branstem/OperationAwesome/media/IMG_0681.JPG

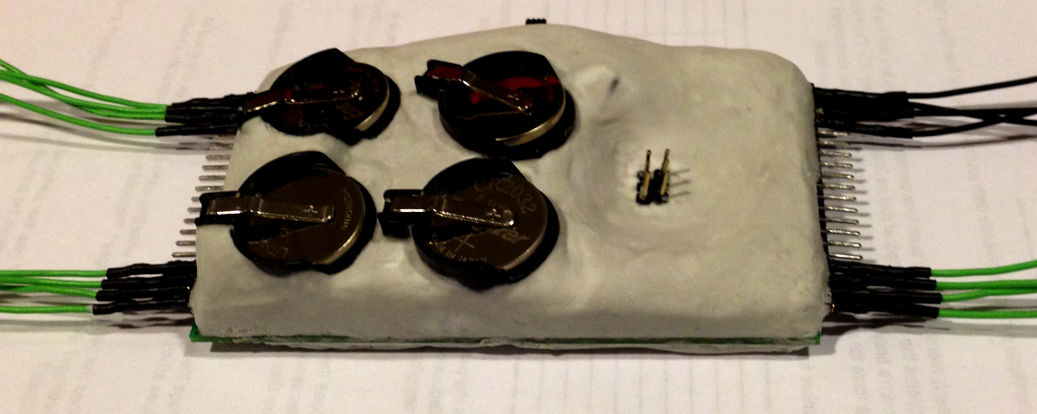
media/IMG_0681.JPG
