branstem/OperationAwesome/media/IMG_0678.JPG

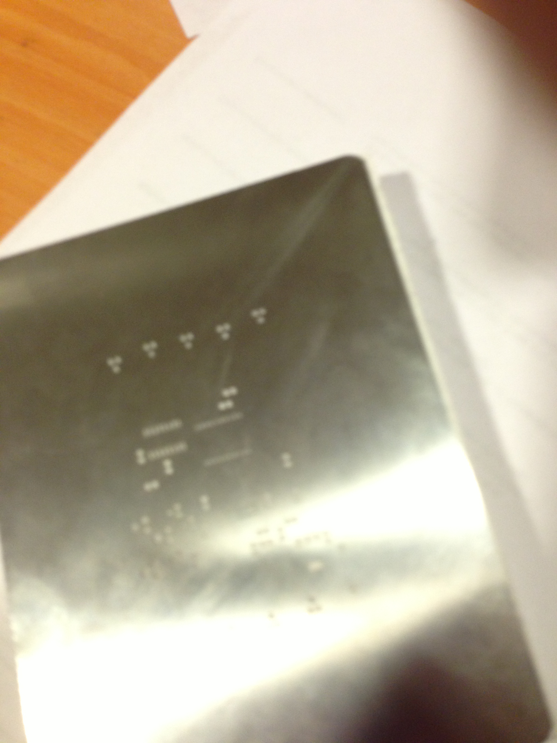
media/IMG_0678.JPG
