branstem/OperationAwesome/README.md

OperationAwesome
================

ECE411 Project
