branstem/OperationAwesome/schematics/readme.txt

This folder was made for circuits.

All unique symbols not shipped with eaglecad should be added to symbols.lbr. 

This library file should also be added to eagles library path to load and 
edit the file.
