branstem/OperationAwesome/datasheets/readme.txt

File in this directory are datasheet for devices used in the schematic.
Please format them as 

Partnumber - function | device class.xxx
