branstem/OperationAwesome/assignments/Assignment 2 - Project Proposal.odt

Proposal for the Design of a Frisbee That Lights Up Based On Measured Acceleration

Matthew Branstetter

Vernon Jones

Yusuf Qedan

Tyler Tricker

ECE411 Practicum Project – Operation Awesome

Electrical Computer Engineering, Portland State University

Submitted to:

Mark Faust

Electrical Computer Engineering, Portland State University

Contents

Executive Summary 3

Design Proposal 3

Project Management 4

Deliverables 4

Budget 4

Wiki 4

Appendix A: Design Matrix 5

Appendix B: Potential Projects 7

Executive Summary

For our ECE 411 practicum project fall term 2012 we need to design something that meets some specific criteria but otherwise is open creatively. Our team discussed several different projects and narrowed the field to four (see appendix B). We then completed a decision matrix to help in decide the project to propose (see appendix A).

The project we chose was not very complex, wouldn’t require significant time to construct and test, and the cost to build is rather conservative. Our focus could be better devoted to the actual design process itself rather than the design. In addition we are able to distinctly assign roles amongst the team based on strengths of team members for the design we chose. Some members are better suited for programming as opposed to hardware. Others have more experience in creating website and wiki’s. Cross loading the workload and utilizing team member strengths will lend to actually have a working design at the completion of the project.

Outside of the criteria, we would like to develop a better understanding of the process or steps in which a product goes through before it reaches the shelf or can be purchased by the consumer. This will help facilitate successful completion of our Capstone Project, and provide answers to possible interview questions following graduation. This project will also build on our knowledge of Electrical and Computer Engineering and aid in getting hired despite our lack of industry experience.

Design Proposal

Our team would like to propose to build a Frisbee which when thrown will light up strategically placed LED’s. The greater the acceleration of the Frisbee the more LED’s that will light up. The uniqueness of the Frisbee will lend to competition amongst throwers to have the most LED’s light up, and for tossing the Frisbee during low light visibility conditions.

The design will consist of a gyro sensor which will provide input to the microcontroller and RGB LED’s that will light up and be the output. An Atmel AVR microcontroller will be used in the design. The PCB will be two sided. The PCB will be no larger than 30 cm². The PCB will be majority surface mount materials. We will utilize a CR123 lithium battery to power the design. The design will be self-contained and be attached to a Frisbee purchased from a local vendor. The Frisbee will be minimally altered to accommodate the PCB and attached LED’s without significantly affecting normal flight response.

On completion of the project our team will have:

1. A completed and working design.
2. Learned the process of designing a product.
3. Gained more hands on experience in our field of study.

Project Management

Our team will utilize a Wiki to update our progress and to augment our regular lines of communication. In addition each member will maintain a design notebook and a log of their time spent on the project. We will meet twice a week to discuss our progress and make any necessary changes or adjustments to successfully complete the project by December 5, 2012.

Deliverables

At the end of the project we will have four working Frisbees in which to demonstrate to our professor. We will also provide video of significant achievements throughout the design progress.

Budget

Out budget is no more than $150 dollars per Frisbee for the project.

Wiki

https://projects.cecs.pdx.edu/projects/fa2012ece411-operationawesome

Appendix A:

Decision Matrix

Project | Complexity 30% | Time 20% | Reliability 15% | Scalability 13% | Re-usability 12% | Inverse Cost 10% | Total 100%
Light up Frisbee | 9 | 9 | 10 | 4 | 4 | 10 | 8
Color calendar | 6 | 7 | 8 | 10 | 7 | 3 | 6.84
Pitch meter | 6 | 7 | 9 | 4 | 6 | 10 | 6.79
Zone Lighting Controller | 6 | 4 | 8 | 10 | 10 | 6 | 6.9

*Criteria is graded on a 0-10 scale where 0 means does not apply or negligible. Higher Numbers are better.

Criteria Selection

The group sat down to decide criteria that was important to us and then ranked them based on our personal preferences. The number selection was generated by each member grading all of the projects, these were then aggregated and rounded to the nearest whole number.

Complexity

Complexity is a measure of the estimated difficulty of design. A Project with a high complexity covers several disjunct disciplines and involves technology unfamiliar to the team members.

Time

Time represents an estimate for time required in design, development, manufacturing, and testing. Some projects might be simple to design but take significant time testing and polishing code.

Reliability

How likely is the project going to work or function during demos and how easily the project would be to operate from other group members.

Scalability

Scalability is a measure of how well the project can be scaled up or down to meet a deadline. Projects with a high scalability means that the project can be extended or reduced without any redesign.

Re-usability

How well the project could be reintegrated into a future project or re-purposed into a different project.

Inverse Cost

Projected Cost Analysis. To keep everything as larger is better the inverse cost score is given. Where 10 is considered to be negligible and 0 would be over $100 per person.

Scale Factors

The simplest scaling formula would be 100% = x1 + x2..... where n of xn is the project number. This scaling factor ignores our personal preferences though so criteria more important to us will be scaled more than that of other criteria. To prevent unfair bias a generic decay formula was derived using a minimum weight and the categories prioritized.

Appendix B:

Potential Projects

Light up Frisbee

A Frisbee that will sense when thrown using a gyroscopic sensor. The average steady state velocity of a Frisbee when thrown is roughly 6 meters per second. Using a motion sensor (G force detector) such as the Durakool G force detector (part number 20878 - T018 Series), when the Frisbee exceeds 6 meters per second it would light up strategically placed LED’s on the Frisbee. The higher the velocity the more LED’s that would light up.

Color Calendar

An automatic time keeper that displays the time and date using color visuals. The input to the device would be a combination of dip switches for daylight savings and time zone information. The time and date itself would be RF synchronized with either the WWCB atomic clock or GPS timestamps. The display itself would be based on natural references, moon cycles, seasons, and atmosphere color changes.

Pitch Meter

A meter with an LED display that changes with a change of pitch. Input would be a microphone or line in. The display would be a series of RGB LEDs that change with color depending on the FFT of the input.

Zone Lighting Controller

A controller with motion detectors that can keep track of a person’s movements and turns lights on and off depending on where they are and where they are heading. The idea was to use sonar sensors to determine a passing persons velocity and position. By using multiple sensors a path and can keep track of multiple people, allowing to automated lighting. Inputs would be the sonar sensors, outputs would be lighting signals to turn zone lights on and off.
