branstem/OperationAwesome/assignments/Assignment 3 - Project Design Specification.odt

Project Design Specification: Frisbee That Lights Up Based On Measured Angular Acceleration and Velocity

Matthew Branstetter

Vernon Jones

Yusuf Qedan

Tyler Tricker

ECE411 Practicum Project – Operation Awesome

Electrical Computer Engineering, Portland State University

Contents

Version notice

All revisions of this document are listed in chronological order. There is no relationship between the document number and the software release number.

Document release | Date | Description
Draft 1 | 08/13/2012 | Established Client Requirements
Draft 2 | 08/14/2012 | Established Design Requirements
Release 1 | 08/15/2012 | First release.
Release 2 | 12/04/2012 | Removed specifications for submerging in 10 M of water, cleaned up format, deleted extraneous specifications outlined in both performance, environmental, product characteristics, and miscellaneous.

This document was created by Operation Awesome, Portland State University. Operation Awesome has made every effort to ensure that this document is accurate at the time of printing. Obtain additional copies of this document, as well as updated releases, from the following organization:

Matthew Branstetter

c/o Operation Awesome

1020 Madison St.

Silverton, OR 97381

Phone: 503-873-3181

Email: matthew.branstetter@hotmail.com

Trademarks

The trademarks contained in this document are the property of their respective owners.

1. Introduction

Purpose

The Project Design Specification (PDS) identifies client and design requirements in order to produce a functioning device. It also provides a benchmark to which designs will be validated.

Scope

For our ECE 411 practicum project fall term 2012 we need to design something that meets some specific criteria but otherwise is open creatively. Outside of the criteria, we would like to develop a better understanding of the process or steps in which a product goes through before it reaches the shelf or can be purchased by the consumer. This will help facilitate successful completion of our Capstone Project, and provide answers to possible interview questions following graduation. This project will also build on our knowledge of Electrical and Computer Engineering and aid in getting hired despite our lack of industry experience.

Summary of changes

The initial draft was created after identifying the client requirements. Additionally, the second draft was created after analyzing the client requirements and our group identifying design requirements. The changes can be seen in Client and Design requirements within this document.

Review/Concurrence information

Matthew Branstetter Initial Review of Draft 1, Draft 2, and Release 1

Vernon Jones Initial Review of Draft 1, Draft 2, and Release 1

Yusuf Qedan Initial Review of Draft 1, Draft 2, and Release 1

Tyler Tricker Initial Review of Draft 1, Draft 2, and Release 1

Mark Faust Review of Release 1

2. Client requirements

Your project can do almost anything but must satisfy the following course requirements:

- Have one or more inputs or sensors.
- Have one or more outputs or transducers.
- Have one or more processing modules which control some of the outputs based on the inputs.
- Use a two layer PCB that is between 1 and 16 in2, with no side of the board being less than 1 inch or more than 12 inches.
- Use components that can be hand soldered or easily soldered in a crude reflow oven.

3. Design requirements

a. Physical and Operational characteristics:

  Performance Requirements

The disk must still be able to sustain flight after assembly. Rotational inertia should be minimally effected. The device must operate in damp conditions. The device must be able to withstand sustained shocks. Batteries must be replaceable.

  Safety

The device must be void of sharp edges that could cut or slice soft tissue at the touch. All electronics must be fully sheathed and covered to protect against burns.

  Testing

The system must be tested for functionality and reliability. Reliability testing must test the requirements outlined in the Operating Environment. The Functionality testing must test the client requirements. Testing may be destructive so multiple prototypes may be desirable.

  Accuracy and Reliability

The gyro sensor should recognize when Frisbee is thrown with a sensitivity of 2000 degrees per second.

  Life in Service

The device will be used multiple times and must last for a minimum of two years.

  Shelf Life

The device must be able to be used for up to two years after production.

  Operating Environment

The device will be used in an outdoor environment and must be able to withstand temperatures ranging between 0 and 55 degrees Celsius (32 and 130 degrees Fahrenheit). The device must be able to withstand surface water without damaging any electrical components.

  Ergonomics

The additional weight of the disc should not increase the rotational inertia high enough so as to cause the user discomfort. Any batteries should be easily replaceable.

  Size

The package must fit on a standard sized disk; standard being defined by the World Flying Disc Federation.

  Materials

The electrical system must consist of a 2 layer PCB, containing more than 75% of surface mount components. The design may be designed in Eagle-CAD. Due to the mobility constraints of a flying disc, it should be operational off a standard battery pack. The PCB must have silk screening as required by the client.

  Cleaning

Device must be able to be cleaned with a moist cloth and should be able to be placed under a typical kitchen faucet with running water without damaging any electrical components.

b. Product Characteristics

  Quantity

One prototype should be constructed. More maybe made as required. The prototype may not be required to follow the same tests as the finished product but the finished product must be tested.

c. Miscellaneous:

  Target Product Cost

Device will be sold singularly to Frisbee enthusiasts. The cost should be no greater than $100.

  Usability
  The disc should be easily usable by any novice flying disc thrower.
  Legal

All design and manufacturing must not infringe on another parties: copyright, trademark, patent rights, or intellectual property. This Project is also released under the GPLv2 license.

  References

GNU GPLv2 - http://www.gnu.org/licenses/gpl-2.0.html.
World Flying Disc Association - http://www.wfdf.org/

Rev. 12/7/2012 Design Project Specification.doc
