branstem/OperationAwesome/assignments/Assignment 4 - Schematic Coversheet.odt

Project Design Specification: Frisbee That Lights Up Based On Measured Angular Acceleration and Velocity

Logical Schematics

Matthew Branstetter

Vernon Jones

Yusuf Qedan

Tyler Tricker

ECE411 Practicum Project – Operation Awesome

Electrical Computer Engineering, Portland State University

Rev. 10/24/2012 1 Design Project Specification.doc
