branstem/OperationAwesome/assignments/System Design and Modeling.pptx

## System Design and Modeling: Frisbee That Lights Up Based On Measured Angular Acceleration and Velocity

Matthew Branstetter
Vernon Jones
Yusuf Qedan
Tyler Tricker
ECE411 Practicum Project – Operation Awesome
Electrical Computer Engineering, Portland State University

## Light-up Frisbee Level 0 Block Diagram

Power 5-7V

Light-up Frisbee

10 RGB LEDs

Module | Light Up Frisbee
Inputs | Power 6V from 2 lithium batteries
Outputs | 10 RGB LED’s 40 pins common anode configuration
Functionality | Based on the measured angular velocity 10 RGB LEDs will light up different patterns and colors

## Light-up Frisbee Level 1 Block Diagram

Logic Power Supply

Power 5v-7V

3.3 V

Lighting Module

3.3 V

Row
Strobe
and
Reset

Logic Module

RGB
LED Outputs

Red Column
Blue Column
Green Column

## Logic Power Supply: Level 0 Block Diagram

Power 5-7V

Logic Power Supply

Power 3.3V

Module | Logic Power Supply
Inputs | Power 5-7V from 2 lithium batteries
Outputs | Power 3.3V
Functionality | Maintains a constant output voltage of 3.3V

## Logic Power Supply: Level 1 Block Diagram

Power 5-7V

Diode

Cap

Voltage Regulator

Power 3.3V

Cap

Decoupling

## Logic Module: Level 0 Block Diagram

Power 3.3V

Logic Circuit

Row Strobe
Row Reset

Red Column
Blue Column
Green Column

Module | Logic Circuit
Inputs | Power 3.3V
Outputs | Row Strobe – Signal to the lighting circuit to activate the next LED. | Red Column – PWM for red brightness
| Row Reset - Signal to the lighting circuit to return to LED0. | Blue Column – PWM for blue brightness
| | Green Column – PWM for blue brightness
Functionality | Measures a rotational velocity and outputs lighting signals as a function of the rotational velocities value.

## Logic Module: Level 1 Block Diagram

Power 3.3V

Gyroscope

ATTINY261

ZOUT

Row Strobe
Row Reset

Red Column
Blue Column
Green Column

## Lighting Module: Level 0 Block Diagram

5-7 V

3.3 V

Lighting Module

Row
Strobe
and
Reset

RGB
Strobe

RGB
LED Outputs

Module | Logic Circuit
Inputs | Row Strobe – Signal to the lighting circuit to activate the next LED. | Red Column – PWM for red brightness
| Row Reset - Signal to the lighting circuit to return to LED0. | Blue Column – PWM for blue brightness
| | Green Column – PWM for blue brightness
Output | 10 RGB LED Outputs
Functionality | Takes lighting signals from the Logic Module and pulses LEDs according to the signal

## Lighting Module: Level 1 Block Diagram

5-7V

3.3 V

Row
Strobe
and
Reset

4017 Decade Decoder

Transistor Array

Transistor Array

Current
Limiter

RGB LED
Anode
Outputs

RGB
Strobe

Red Column
Green Column
Blue Column
