branstem/OperationAwesome/assignments/Final Presentation Slides.odp

## Operation: Awesome

Matthew Branstetter

Vernon Jones

Yusuf Qedan

Tyler Tricker

## Motivation

- To design a project that follows current standards and practices used in industry
- Develop team cohesion and work on communication skills

## Objective

- To create a blinking Frisbee that adheres to the project requirements and specifications
- Have a working project and demonstrate at the completion of Fall term

## Alternatives

- WHAMMO Frisbee Disc Twilight Blast - $19.99
  - 150 grams
  - 2 LEDs diffused through plastic
  - Runs off of 3 LR44 batteries
- Flashflight - $19.99
  - 185 grams
  - 1 super right LED diffused through plastic
  - Runs off of 2 CR2016

## Requirements

- Have one or more inputs or sensors
- Have one or more outputs or transducers
- Have one or more processor modules
- Two layer PCB
- Have components that can be hand soldered or easily soldered in a crude reflow

## Our Approach

- Our method was a top down approach to design
- Broke the project into interface module and LED module
- Developed modules independently
- Then combined the two on completion for the final design

## Design: UML

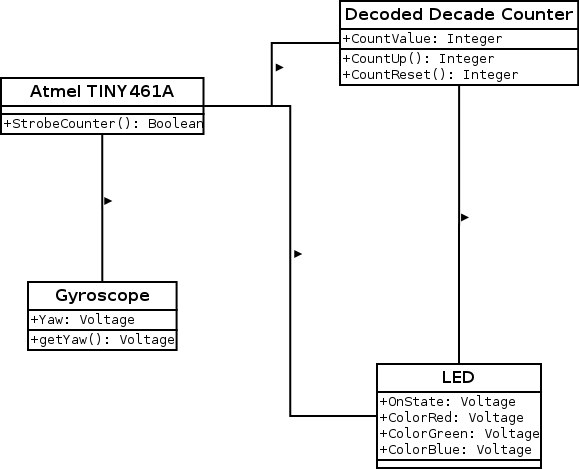
[picture p3: figure]

## Design: UML

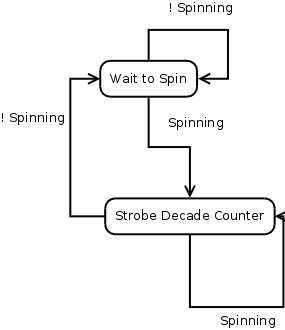
[picture p4: figure]

## Design: Software Algorithm

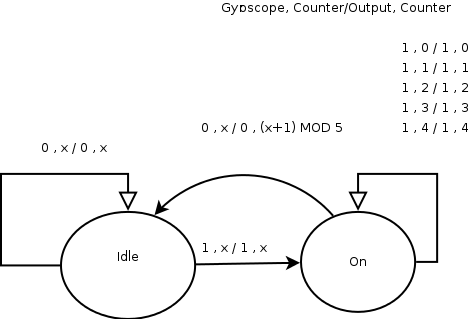
[picture p5: figure]

## Light-up Frisbee Level 0 Block Diagram

Light-up Frisbee

Power 5-7V

10 RGB LEDs

Module | Light Up Frisbee
Inputs | Power 6V from 2 lithium batteries
Outputs | 10 RGB LED’s 40 pins common anode configuration
Functionality | Based on the measured angular velocity 10 RGB LEDs will light up different patterns and colors

## Light-up Frisbee Level 1 Block Diagram

Logic Power Supply

Power 5v-7V

3.3 V

Lighting Module

Row
Strobe
and
Reset

3.3 V

RGB
LED Outputs

Logic Module

Red Column
Blue Column

Green Column

## Logic Power Supply: Level 0 Block Diagram

Logic Power Supply

Power 5-7V

Power 3.3V

Module | Logic Power Supply
Inputs | Power 5-7V from 2 lithium batteries
Outputs | Power 3.3V
Functionality | Maintains a constant output voltage of 3.3V

## Logic Power Supply: Level 1 Block Diagram

Power 5-7V

Diode

Voltage Regulator

Power 3.3V

Cap

Cap

Decoupling

## Logic Module: Level 0 Block Diagram

Logic Circuit

Power 3.3V

Row Strobe

Row Reset

Red Column
Blue Column

Green Column

Module | Logic Circuit
Inputs | Power 3.3V
Outputs | Row Strobe – Signal to the lighting circuit to activate the next LED. | Red Column – Turn Red on or off
| Row Reset - Signal to the lighting circuit to return to LED0. | Blue Column –Turn Blue on or off
| | Green Column – Turn Green on or off
Functionality | Measures a rotational velocity and outputs lighting signals as a function of the rotational velocities value.

## Logic Module: Level 1 Block Diagram

Gyroscope

ATTINY461A

Power 3.3V

ZOUT

Row Strobe

Row Reset

Red Column
Blue Column

Green Column

## Lighting Module: Level 0 Block

5-7 V

3.3 V

Lighting Module

Row
Strobe
and
Reset

RGB
Strobe

RGB
LED Outputs

Module | Logic Circuit
Inputs | Row Strobe – Signal to the lighting circuit to activate the next LED. | Red Column – PWM for red brightness
| Row Reset - Signal to the lighting circuit to return to LED0. | Blue Column – PWM for blue brightness
| | Green Column – PWM for blue brightness
Output | 10 RGB LED Outputs
Functionality | Takes lighting signals from the Logic Module and pulses LEDs according to the signal

## Lighting Module: Level 1 Block Diagram

5-7V

3.3 V

Row
Strobe
and
Reset

4017 Decade Decoder

Transistor Array

Current
Limiter

RGB LED
Anode
Outputs

Red Column
Green Column

Blue Column

Transistor Array

RGB
Strobe

## Lighting Design Selection

  Matrix Layout

Pin~Complexity = 2 cdot log_2{N}

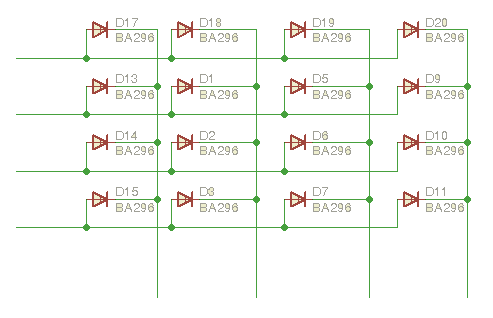
[picture p6: figure]

## Lighting Design Selection

  Shift Register Layout

Pin~Complexity = K

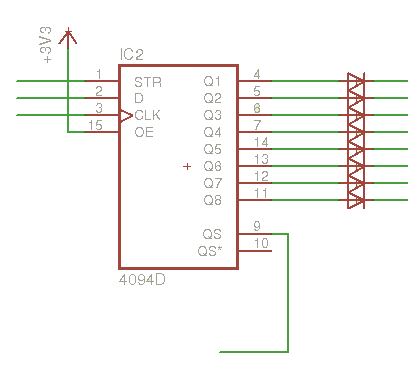
[picture p7: figure]

## Lighting Design Selection

  Counter layout

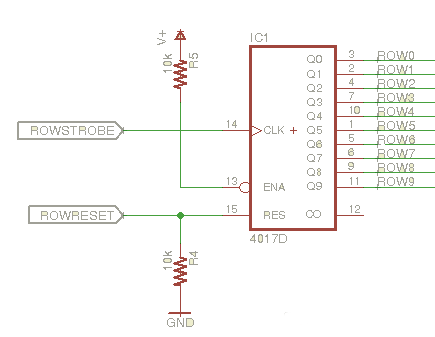
[picture p8: figure]

Pin~Complexity = {N} over {5}

## Design: Decisions Made

- Processor module – AVR suggested
  - AT mega
    - 256KB flash
    - 28-100 I/O pins
    - 20 MHz
  - AT tiny
    - 8KB flash
    - 6-32 I/O pins
    - 20 MHz
  Decision: AT tiny461A

## Design: Decisions Made

- Gyro Sensor
  - Digital
    - Interface with Processor module
    - Expensive
  - Analog
    - AVR Analog/Digital converter
    - Cheaper
  Decision: STMicroelectronics LY3200ALH

## Design: Decisions Made

- Power Supply
  - LM1117 3.3V fixed LDO
    - Readily Available
    - Used frequently
  Decision: LM1117 3.3V fixed LDO
  - Battery
    - CR123 – 1500mAh (Lithium)
    - CR2032 – 250mAh (Lithium)
  Decision: CR2032 X 2 (6.6V)

## Design: Decisions Made

- LED
  - Time Division Multiplexing on LED's
    - 4017 Johnson counter with decoded outputs
    - MosFET drivers
    - Adjustable Pots on RGB Channels for different LED foreword voltages
  - Support RGB LEDs

## Implementation: Schematics

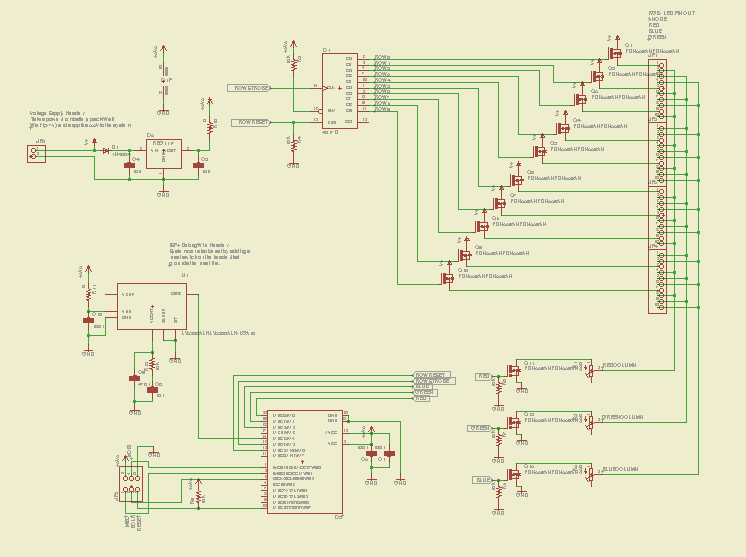
[picture p9: figure]

## Implementation: Microcontroller

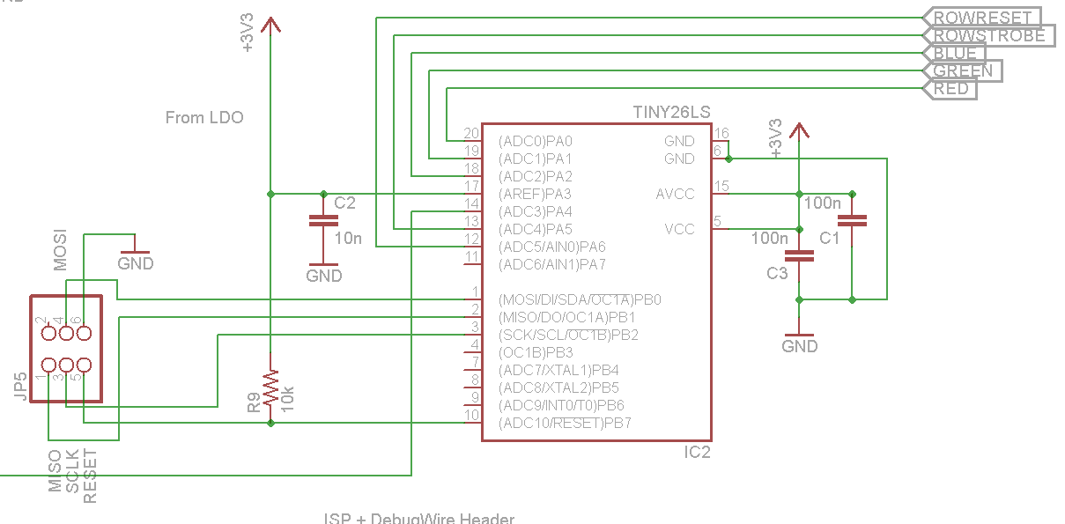
[picture p10: figure]

## Implementation: Gyroscope

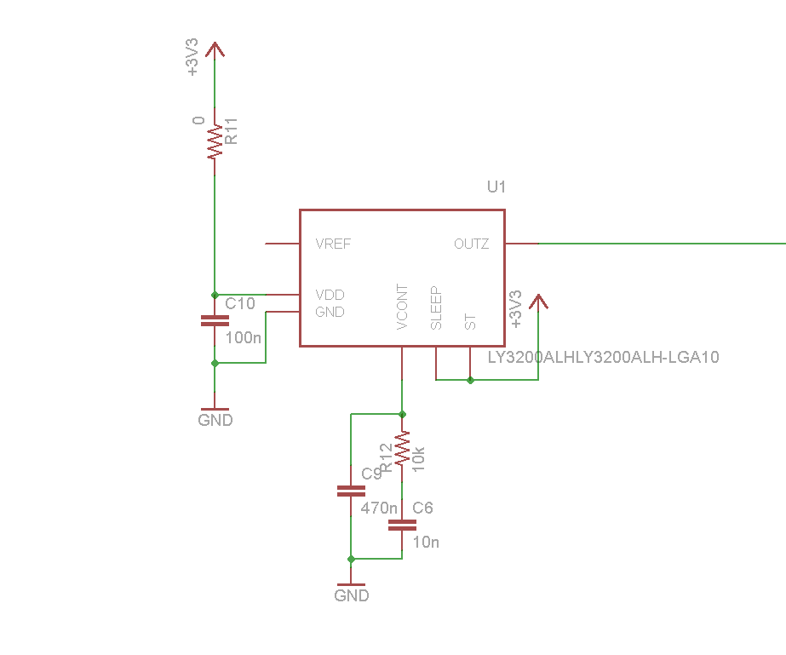
[picture p11: figure]

## Implementation: Power System

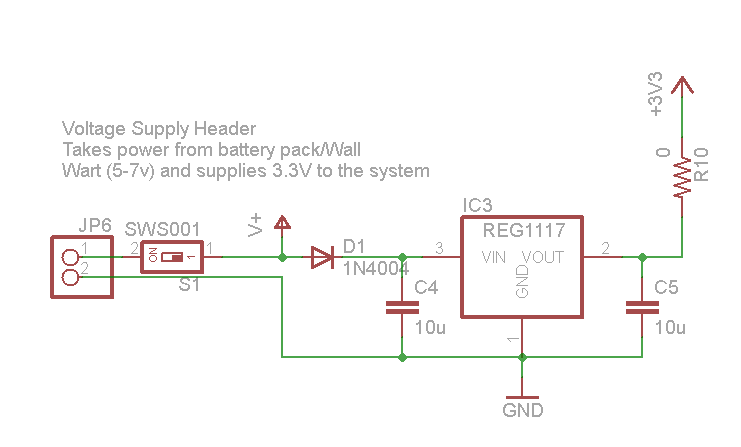
[picture p12: figure]

## Implementation: Decade Counter

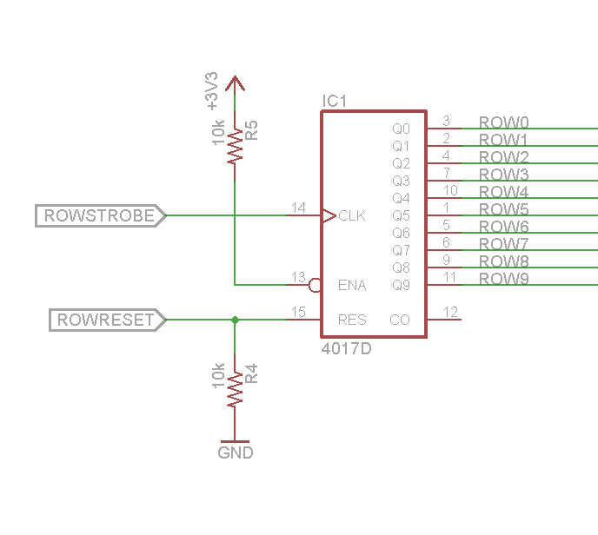
[picture p13: figure]

## Implementation: Red, Blue, Green

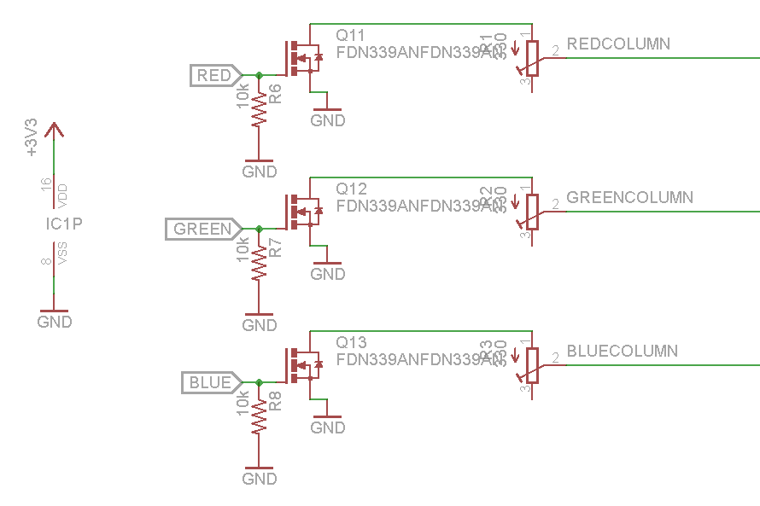
[picture p14: figure]

## Prototyping

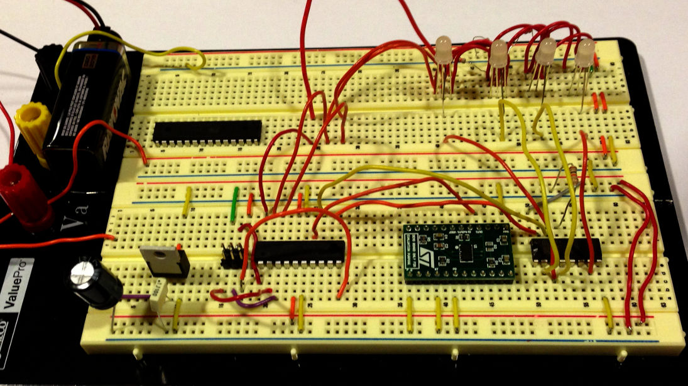
[picture p15: figure]

## Implementation: PCB

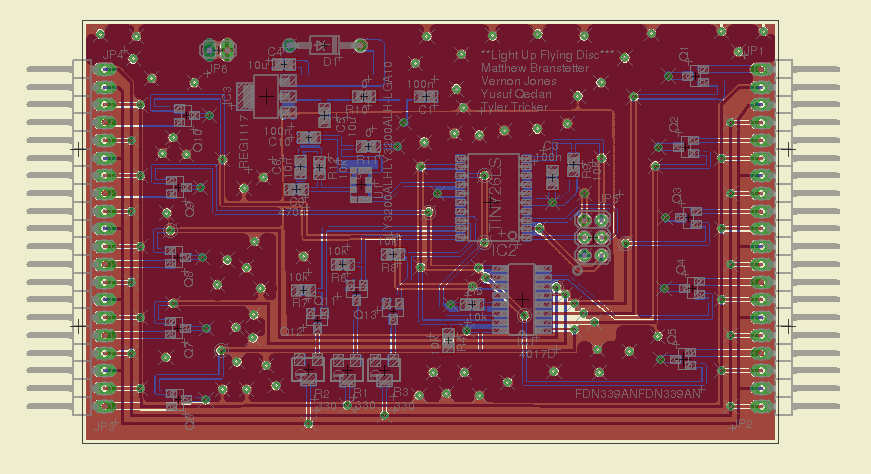
[picture p16: figure]

## Implementation: Tools Employed

- EAGLE CAD
- AVR Studio 6.0
- Gantt Project/Microsoft Project
- Libreoffice

## Implementation: Tools Employed

- Skype
- Git
- Redmine
- AVRISP MKII Programmer
- AVR JTAG ICE3 Programmer/Debugger

## IP, Prior Work

- Component Datasheets
- No other IP or prior work used

## Testing

- Power Test: Check for bridges between Power, Ground, and 3.3V
- LED Test: Light up a single LED
- Scheduler Test: Light up all LEDs a single color
- Color Test: Light one LED at a time, Red, Green, then Blue
- Gyro Test: Light LEDs based on Gyro State

## Results

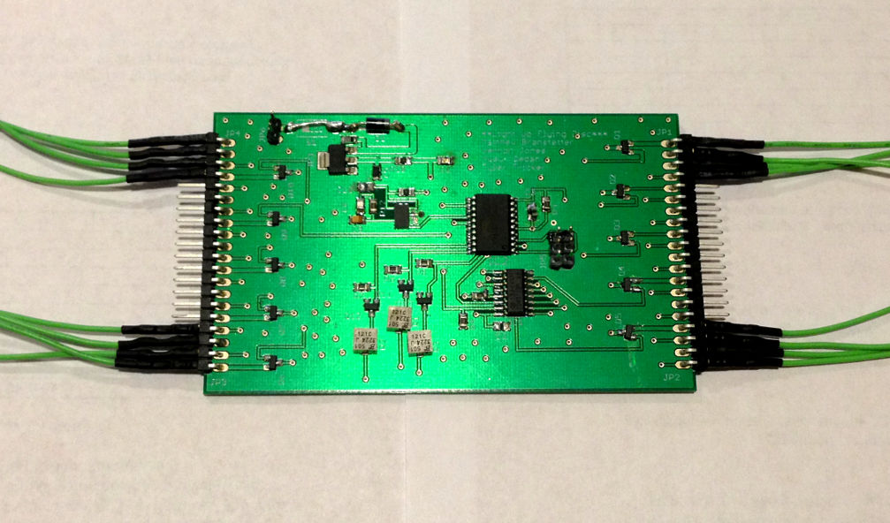
[picture p17: figure]

## Results


## Modifications to Board Layout

## Board Demo Videos

## Contributions

- Matthew: Interface Module
- Vernon: Programming
- Yusuf: Test Plan, Components
- Tyler: PCB Layout, LED module

## Lessons Learned:

- Reflow: One board at a time
- Reflow: Main components and hand-solder capacitors, resistors, and MOSFETs
- Don't reflow on through-hole components
- Slow is Fast
- More thorough test plan

## Circuit Improvements

- 9V battery – Board density
- Angled power and ISP headers
- More 0-ohm resistor jumpers
- LED headers – all four sides
- LEDs directly on PCB
- Separate large components from small
- Higher gate voltage

## Questions?
