branstem/OperationAwesome/assignments/Final Presentation Slides.pptx

Operation: Awesome

Frisbee that lights up when thrown

## Slide 2

Requirements

- When thrown, LEDs light up in different patterns
- Designed to be easily programmable
- System must withstand shocks from hitting walls or the ground

## Slide 3

Specifications

- Device must fit on disk (Frisbee)
- Disk flight must be minimally affected by attachment of system
- Device batteries must be replaceable
- Device must be re-programmable

## Slide 4

Bill of Materials (BOM)

Vendor Part Number | Manufacturer Part Description | Quantity | Ordered? | Vendor | Unit Price | Total Price
338-2772-1-ND | CAP FILM 0.1UF 16VDC 0805 | 3 | X | DIGIKEY | $0.45 | $1.36
PCF1196CT-ND | CAP FILM 10000PF 16VDC 0805 | 2 | X | DIGIKEY | $0.67 | $1.34
511-1683-1-ND | CAP TANT 10UF 16V 20% 0805 | 2 | X | DIGIKEY | $1.27 | $2.54
478-3964-1-ND | CAP TANT 0.47UF 20V 10% 0805 | 1 | X | DIGIKEY | $1.24 | $1.24
641-1311-1-ND | DIODE RECTIFIER 1A 400V DO-41 | 1 | X | IEEE Student Store | $0.11 | $0.11

## Slide 5

Bill of Materials (BOM)

Vendor Part Number | Manufacturer Part Description | Quantity | Ordered? | Vendor | Unit Price | Total Price

296-25940-1-ND | IC 10-OUT DECADE COUNTER 16-SOIC | 1 | X | DIGIKEY | $0.45 | $0.45
ATTINY461A-SU-ND | IC MCU AVR 4K FLASH 20MHZ 20SOIC | 1 | X | DIGIKEY | $1.61 | $1.61
REG1117-3.3-ND | IC REG LDO 3.3V .8A SOT223-4 | 1 | X | DIGIKEY | $2.79 | $2.79
SAM1051-50-ND | CONN HDR 50POS .100" SNGL R/A | 4 | X | DIGIKEY | $2.46 | $9.84
| | 1 | Student store | Pololu | $1.95 | $1.95
| | 1 | Student store | Pololu | $1.95 | $1.95

## Slide 6

Bill of Materials (BOM)

FDN335NCT-ND | MOSFET N-CH 20V 1.7A SSOT3 | 13 | X | DIGIKEY | $0.28 | $3.63
3224J-1-501ECT-ND | TRIMMER 500 OHM 0.25W SMD | 1 | X | DIGIKEY | $3.50 | $3.50
CR0805-FX-1002ELFCT-ND | RES 10K OHM 1/8W 1% 0805 SMD | 6 | X | | $0.01 | $0.07
CR0805-J/-000ELFCT-ND | RES 0.0 OHM 1/8W JUMPER 0805 SMD | 1 | X | | $0.01 | $0.01
CKN9490CT-ND | SWITCH DIP TAPE SEALED 1POS SMD | 1 | X | DIGIKEY | $1.23 | $1.23
497-10146-ND | GYRO 2000DEG/S 0.67MV 10LGA | 1 | X | DIGIKEY | $4.51 | $4.51

## Slide 7

Bill of Materials (BOM)

5050-RGB | RGB 5050 SMD LED | 10 | X | | $0.67 | $6.70
| | | | Total | Board | $44.82
| | | | | 4 Boards | $179.30

## Slide 8

Prototyping

## Slide 9

Assembly
