branstem/OperationAwesome/media/IMG_0675.JPG

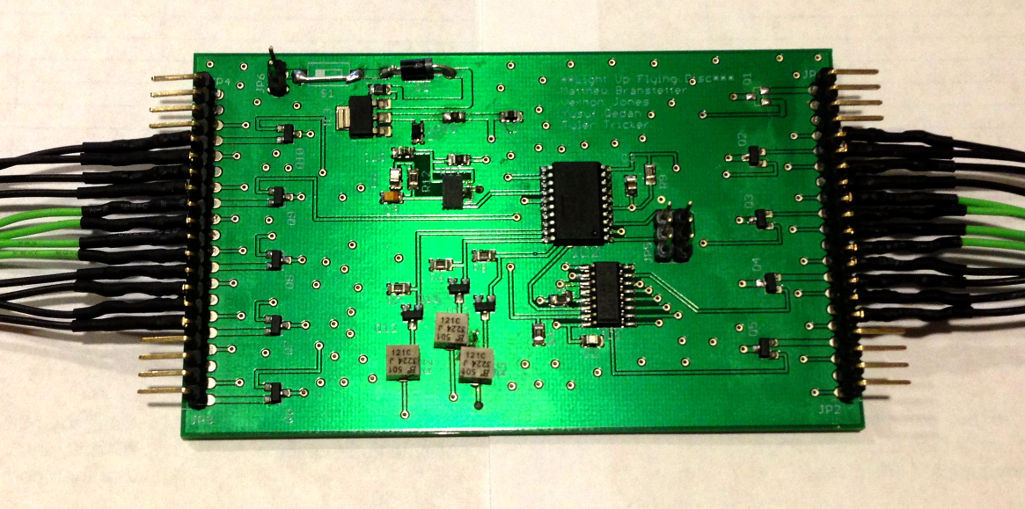
media/IMG_0675.JPG
