branstem/OperationAwesome/media/IMG_0676.JPG

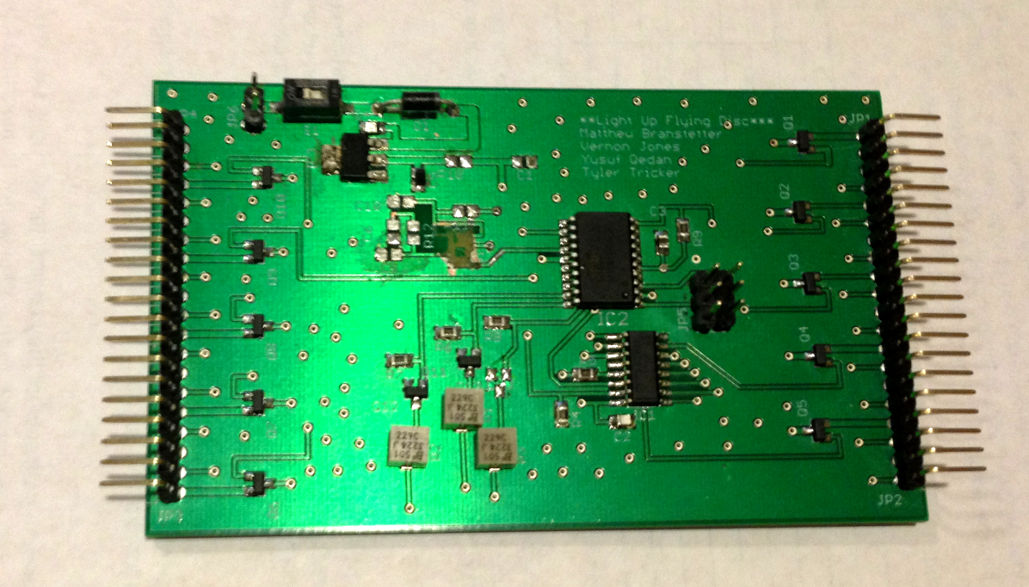
media/IMG_0676.JPG
