branstem/OperationAwesome/media/IMG_0679.JPG

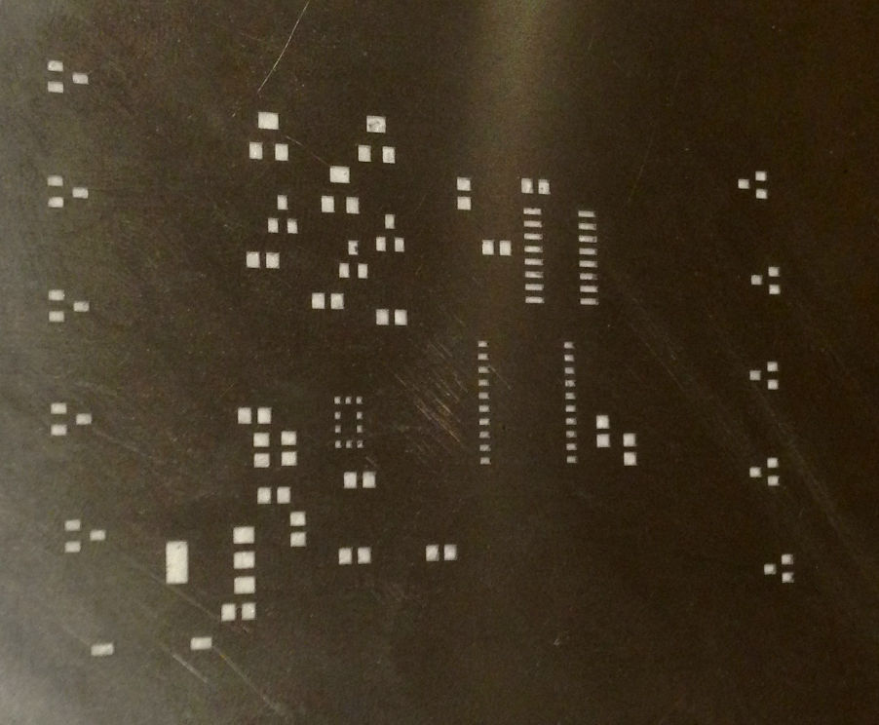
media/IMG_0679.JPG
