branstem/OperationAwesome/media/IMG_0682.JPG

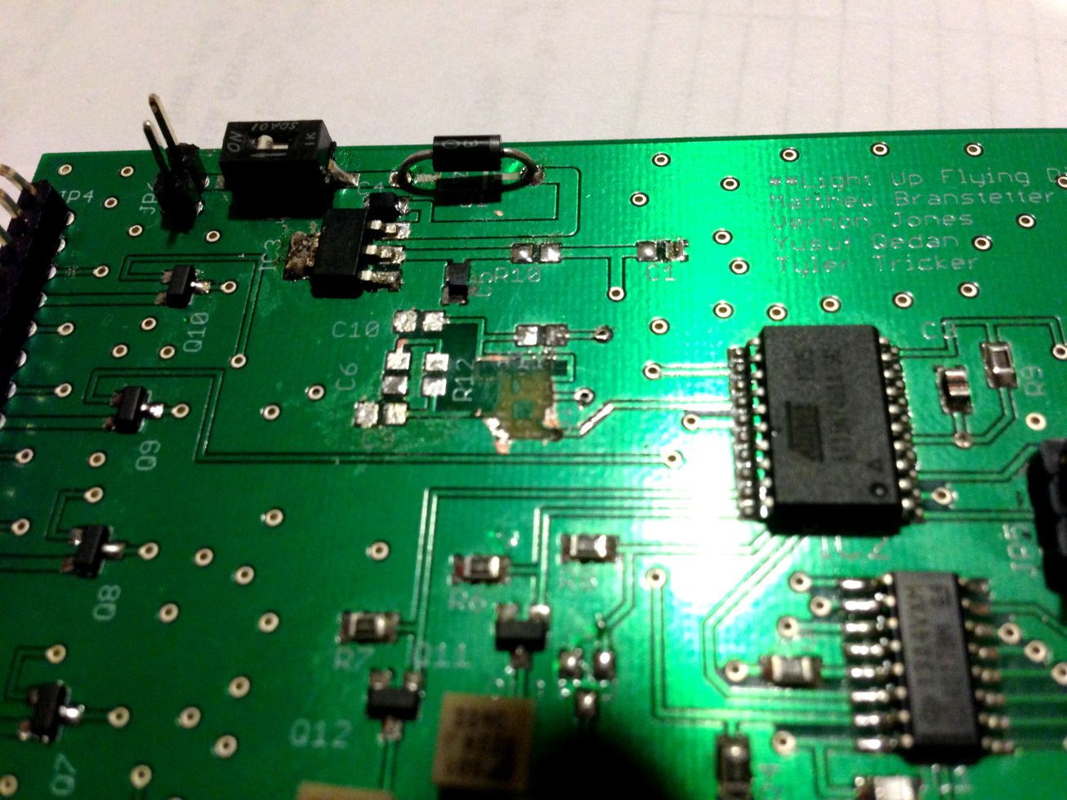
media/IMG_0682.JPG
