branstem/OperationAwesome/media/unified circuit schematic.png

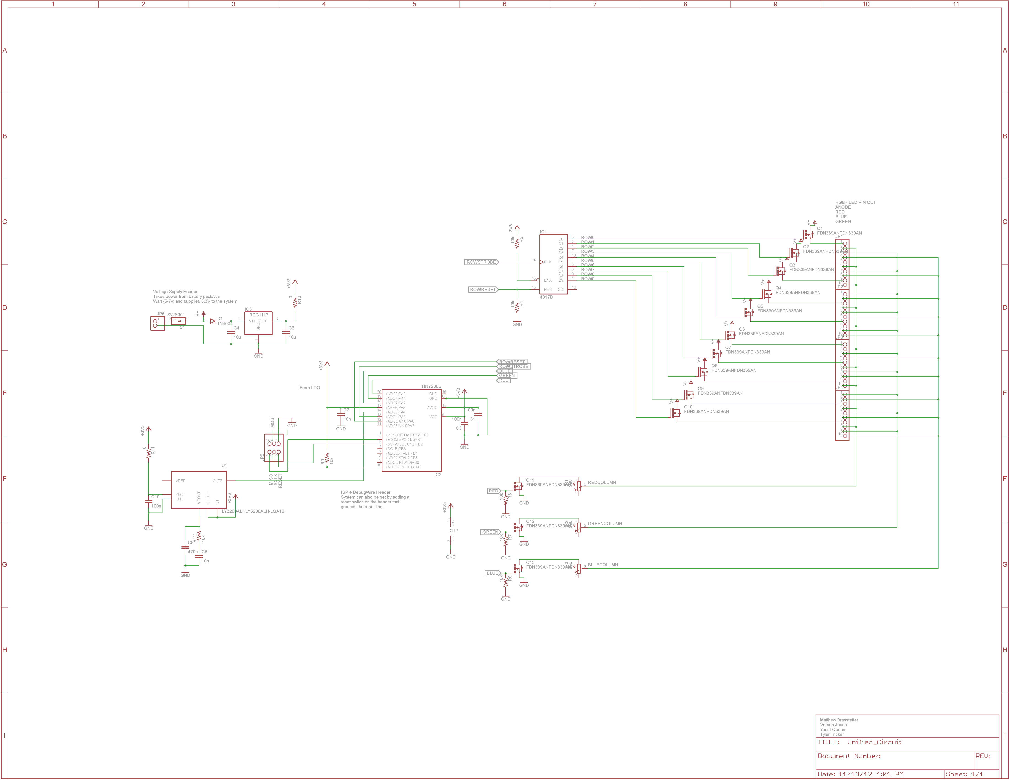
media/unified circuit schematic.png
