branstem/OperationAwesome/bom/Bill Of Materials.xls

PCB Components (Per Board)
Part | Value | Eagle Device | Eagle Package | Library | Vendor Part Number | Manufacturer Part Description | Quantity | Ordered? | Vendor | Unit Price | Total Price | URL
C1,C3,C10 | 100n | C-EUC0805 | C0805 | rcl | 338-2772-1-ND | CAP FILM 0.1UF 16VDC 0805 | 3 | X | DIGIKEY | $0.45 | $1.36 | http://www.digikey.com/product-detail/en/FCA0805C104M-J2/338-2772-2-ND/1924083
C2, C6 | 10n | C-EUC0805 | C0805 | rcl | PCF1196CT-ND | CAP FILM 10000PF 16VDC 0805 | 2 | X | DIGIKEY | $0.67 | $1.34 | http://www.digikey.com/product-detail/en/FCP0805C103G/FCP0805C103G-ND/1924304
C4, C5 | 10u | C-EUC0805 | C0805 | rcl | 511-1683-1-ND | CAP TANT 10UF 16V 20% 0805 | 2 | X | DIGIKEY | $1.27 | $2.54 | http://www.digikey.com/product-detail/en/TCTP1C106M8R/511-1683-2-ND/2289843
C9 | 470n | C-EUC0805 | C0805 | rcl | 478-3964-1-ND | CAP TANT 0.47UF 20V 10% 0805 | 1 | X | DIGIKEY | $1.24 | $1.24 | http://www.digikey.com/product-detail/en/TAJR474K020RNJ/478-3964-2-ND/1126892
D1 | 1N4004 | 1N4004 | DO41-10 | diode | 641-1311-1-ND | DIODE RECTIFIER 1A 400V DO-41 | 1 | X | IEEE Student Store | $0.11 | $0.11
IC1 | 4017D | 4017D | SO16 | 40xx | 296-25940-1-ND | IC 10-OUT DECADE COUNTER 16-SOIC | 1 | X | DIGIKEY | $0.45 | $0.45 | http://www.digikey.com/product-detail/en/CD4017BM96/296-25940-2-ND/1690809
IC2 | TINY26LS | TINY26LS | SO20L | atmel | ATTINY461A-SU-ND | IC MCU AVR 4K FLASH 20MHZ 20SOIC | 1 | X | DIGIKEY | $1.61 | $1.61 | http://www.digikey.com/product-detail/en/ATTINY461A-SUR/ATTINY461A-SUR-ND/2357422
IC3 | REG1117 | REG1117 | SOT223 | burr-brown | REG1117-3.3-ND | IC REG LDO 3.3V .8A SOT223-4 | 1 | X | DIGIKEY | $2.79 | $2.79 | http://www.digikey.com/product-detail/en/LM1117MPX-3.3%2FNOPB/LM1117MPX-3.3%2FNOPBTR-ND/366733
JP1-4 | LED LIGHTS | PINHD-1X10/90 | 1X10/90 | pinhead | SAM1051-50-ND | CONN HDR 50POS .100" SNGL R/A | 4 | X | DIGIKEY | $2.46 | $9.84 | http://www.digikey.com/product-detail/en/TSW-150-08-T-S-RA/SAM1051-50-ND/1102374
JP5 | ISP | PINHD-2X3 | 2X03 | pinhead |  |  | 1 | Student store | Pololu | $1.95 | $1.95 | http://www.pololu.com/catalog/product/966
JP6 | PWR | PINHD-1X2 | 1X02 | pinhead |  |  | 1 | Student store | Pololu | $1.95 | $1.95 | http://www.pololu.com/catalog/product/966
Q1-13 | FDN339ANFDN339AN | FDN339ANFDN339AN | SSOT-3 | symbols | FDN335NCT-ND | MOSFET N-CH 20V 1.7A SSOT3 | 13 | X | DIGIKEY | $0.28 | $3.63 | http://www.digikey.com/product-detail/en/FDN335N/FDN335NTR-ND/965301
R1-3 | 330 | R-TRIMM3224W | RTRIM3224W | rcl | 3224J-1-501ECT-ND | TRIMMER 500 OHM 0.25W SMD | 1 | X | DIGIKEY | $3.50 | $3.50 | http://www.digikey.com/product-detail/en/3224J-1-501E/3224J-1-501ETR-ND/1817445
R4-9,R12 | 10k | R-US_R0805 | R0805 | rcl | CR0805-FX-1002ELFCT-ND | RES 10K OHM 1/8W 1% 0805 SMD | 6 | X |  | $0.01 | $0.07
R10,R11 | 0 | R-US_R0805 | R0805 | rcl | CR0805-J/-000ELFCT-ND | RES 0.0 OHM 1/8W JUMPER 0805 SMD | 1 | X |  | $0.01 | $0.01
S1 | SDA01H0SBR | SWS001 | SMS-001 | smd-special | CKN9490CT-ND | SWITCH DIP TAPE SEALED 1POS SMD | 1 | X | DIGIKEY | $1.23 | $1.23 | http://www.digikey.com/product-detail/en/SDA01H0SBR/CKN9490TR-ND/1961376
U1 | LY3200ALHLY3200ALH | LY3200ALHLY3200ALH-LGA10 | LGA10 | symbols | 497-10146-ND | GYRO 2000DEG/S 0.67MV 10LGA | 1 | X | DIGIKEY | $4.51 | $4.51 | http://www.digikey.com/product-detail/en/LY3200ALHTR/497-11080-2-ND/2214507
Peripherals
 |  | 1x5 IDC Connector Shell |  |  |  |  | 10 |  | Pololu |  | $0.00 | http://www.pololu.com/catalog/product/1904
 |  | IDC Female Terminated Wires |  |  |  |  | 20 |  | Pololu |  | $0.00 | http://www.pololu.com/catalog/product/1806
 |  | RGB LEDs |  |  | 5050-RGB | RGB 5050 SMD LED | 10 | X |  | $0.67 | $6.70 | http://www.superbrightleds.com/moreinfo/surface-mount-smd/rgb-5050-smd-led-120-degree-viewing-angle/322/1254/
Building Materials
 |  |  |  |  |  |  |  |  | Total | Board | $44.82
 |  |  |  |  |  |  |  |  |  | 4 Boards | $179.30
