branstem/OperationAwesome/assignments/Assignment 6 - Test Plan.odt

Test Plan: Frisbee That Lights Up Based On Measured Angular Acceleration and Velocity

Matthew Branstetter

Vernon Jones

Yusuf Qedan

Tyler Tricker

ECE411 Practicum Project – Operation Awesome

Electrical Computer Engineering, Portland State University

Version Notice

All revisions of this document are listed in chronological order. There is no relationship between the document number and the software release number.

Document release | Date | Description
Draft 1 | 11/24/2012 | Created Outline for Test Plan
Draft 2 | 11/25/2012 | Added Test Case 1 and 2
Draft 3 | 11/25/2012 | Added Test Case 3
Draft 4 | 11/25/2012 | Added Test Case 4
Draft 5 | 11/25/2012 | Modified Test Plan to include Environmental Testing
Release | 11/26/2012 | First release.
Version 2 | 12/07/2012 | Final Release

This document was created by Operation Awesome, Portland State University. Operation Awesome has made every effort to ensure that this document is accurate at the time of printing. Obtain additional copies of this document, as well as updated releases, from the following organization:

Matthew Branstetter

c/o Operation Awesome

1020 Madison St.

Silverton, OR 97381

Phone: 503-873-3181

Email: matthew.branstetter@hotmail.com

Trademarks

The trademarks contained in this document are the property of their respective owners.

# 1 Introduction

The Test Plan outlines the scope, approach, resources, and schedule for testing the blinking Frisbee PCB. It identifies the items and features to be tested, and types of testing. This test plan will cover testing of PCB required prior to potting and attaching to Frisbee. Additional testing after potting and attaching to Frisbee will be conducted as well.

## 1.1 Objectives

The objective of the project is to develop a blinking Frisbee that lights up and reacts to angular velocity or acceleration. These test plans should be able to show all the functionality and features defined in the project design specification document.

## 1.2 Testing Strategy

For each level of testing, a separate test plan is prepared with the following set of deliverables:

- Test Case Number
- Features to be tested
- Items to be tested
- Pass / Fail criteria
- Input File Names
- Output File Names
- Expected Results
- Actual Results

## 1.3 Scope

The scope of this test plan is to make sure that all the requirements are met and developed. Both scheduled and unscheduled test plan changes will be completed and documented in future test plan revisions.

## 1.4 Reference Material

All the documents and sources referenced in the Test Plan are below:

- Project Proposal
- Project Design Specification
- PCB Schematic
- Block Diagrams and UMLs
- ATMEL AVR Technical Library (June 2011)
- 2588E–AVR–08/10, ATTINY461 data sheet

## 1.5 Points of Contact

The main point of contact for this test plan is:

Matthew Branstetter

c/o Operation Awesome

1020 Madison St.

Silverton, OR 97381

Phone: 503-873-3181

Email: matthew.branstetter@hotmail.com

## 1.6 Methodology, Tools, and Techniques

There will be some software and hardware tools used during the test plan (See Environmental Requirements). The methodology used is a bottom up approach. Smaller portions of the PCB will be tested individually, and then the entire system as a whole.

# 2 Test Planning

The test activities will be performed by using the project proposal, project design specification, and any additional hardware and software manuals.

## 2.1 Functionality Testing

Basic Functionality testing will be conducted to ensure the blinking Frisbee PCB basic components are working. The basic components include, voltage regulator, gyro sensor, battery pack, and micro controller. The requirements will be tested and verified by all members of Operation Awesome. This is covered under Test Case 1.

## 2.2 Unit Testing

Unit testing will be conducted to verify the implementation of each basic and major components of the blinking Frisbee PCB. The major components include: mosfets, decade counter, and RGB LED s. The requirements will be tested and verified by all members of Operation Awesome. After any new component or feature is added, unit testing will be done for them as well. This is covered under Test Case 1, 2, and 3.

## 2.3 Performance Testing

Performance Testing will be conducted to ensure that the blinking Frisbee performs to the expectations. Performance testing will be conducted after blinking Frisbee PCB has been tested, potted, and attached to Frisbee. Performance testing will be conducted in Test Case 3 and 4.

## 2.4 Environmental Testing

Environmental Testing will be conducted to ensure that the blinking Frisbee performs to the environmental specifications. Environmental testing will be conducted after blinking Frisbee PCB has been tested, potted, and attached to Frisbee. Environmental testing will be conducted in Test Case 4.

## 2.5 Regression Testing

Regression Testing will be conducted to ensure that any additional components or features added have not adversely affected previously tested functionality. All the previously defined test cases will be applied with the each new case, and pass or fail of each test case will be determined.

## 2.6 Pass / Fail Criteria

The Pass/Fail criteria are identified in the test cases created in the section 6. Each test case has its own pass/fail criteria defined.

# 3 Project Management

## 3.1 Test Deliverables

The deliverables from the test process, including report logs, incident reports, and summary reports. Printouts from ATMEL Studio and videos of prototype will be delivered as well.

Deliverable | Role | Responsibility | Start Date | End Date
Output Files created. | To be able to show the functionality of the PCB components. | Proves the requirements are implemented for blinking Frisbee PCB. | 11/26/2012 | 12/05/2012
Videos | To be able to show components of PCB in action | Show blinking Frisbee PCB and LEDs responds to sensory input. | 11/26/2012 | 12/05/2012

Table 1 — Test Deliverables

## 3.2 Constraints

This project is a blinking Frisbee prototype that responds to angular acceleration and velocity. The prototype is designed as a practicum project for ECE411 which is a requirement for a BS in Computer Engineering at Portland State University. This is a prototype only and there are no plans to market the Frisbee.

## 3.3 Issues

Below are the issues that may affect the development and operation of the test plan, e.g. communications, security, training.

Ref | Issue | Action
1 | Testing Group needs to be trained to use additional hardware. | Testing group will run through tutorial and review training videos provided by ATMEL.
2 | Testing Group needs to be trained to use additional software. | Testing group will run through tutorial and review training videos provided by ATMEL.

Table 2 — Issues

## 3.4 Assumptions

All assumptions regarding the test plan are below.

Ref | Assumption | Impact
1 | Windows XP, VISTA, or 7 installed on PC. | To be able to run additional software required to run test cases.
2 | AVR Studio 6 is installed. | To be able to test the test cases.
3 | JTAGICE3 is connected to ISP on PCB and USB on PC prior to running AVR Studio 6. | For communication with micro controller and debugger to properly work, connections must be made prior to starting AVR Studio 6.
4 | Power is supplied to PCB by other means than the ISP, debugger, or PC. | For AVR Studio 6 to communicate with micro controller, the PCB must have power supplied and power switch on.

Table 3 — Assumptions

## 3.5 Dependencies

The main dependencies regarding the plan.

Ref | Dependency | Action
1 | Debugger link with micro controller. | Debugger must be connected to ISP and PC prior to opening AVR Studio 6.0.
2 | AVR Studio 6.0 is able to communicate with ISP. | Power is supplied to micro controller from external source prior to starting AVR Studio 6.0.

Table 4 — Dependencies

# 4 Environmental Requirements

The testing environment will mirror the developmental environment when possible. The test environment will be in a Windows environment only. Some software development was done in a Linux environment but in order to limit the training and time constraints for group members, only Windows environment will be used. A more exhaustive testing procedure in a Linux environment will be conducted at a later date. Below are the hardware and software requirements for the test environment.

## 4.1 Hardware

The hardware requirements for testing activities are:

Ref | Hardware | Purpose
1. | Any PC with a Universal Serial Bus 2.0/3.0 | To be able to connect debugger to prototype PCB
2. | AVR JTAGICE3 debugger | To be able to connect prototype PCB to PC

Table 5 — Hardware

## 4.2 Software

The software requirements for testing activities are:

Ref | Software | Purpose
1. | Windows XP, Vista, 7 etc. | The test system environment is in a Windows operating systems
2. | ATMEL Studio 6.0 | To be able to debug prototype

Table 6 — Software

# 5 Plan Approvals

This test plan will be approved by Operation Awesome.

## 5.1 Sign-Off Criteria

Below are the individuals authorized to sign off the plan.

Name | Role | Signature | Date
Matthew Branstetter | PSU student | | 12/05/2012
Vernon Jones | PSU student | | 12/05/2012
Yusuf Qedan | PSU student | | 12/05/2012
Tyler Tricker | PSU student | | 12/05/2012
Prof. Mark Faust | Portland State University | | 12/05/2012

Table 7 — Sign-off Criteria

# 6 Test Plan/Test Results for Blinking Frisbee

This document first revised in 25 November 2012.

## 6.1 Test Case Number: 1

Requirements Tested: Voltage Regulator, Power, pin connections

Steps:

1- Check power and ground lines for shorts

2- Check ground and 3V3 lines for shorts

3- check power and 3V3 lines for shorts

Expected Results:

If the lines aren't shorted, power can be safely applied to the board.

Actual Results: Passed

Pass / Fail Criteria: If the Actual Results exactly matches the Expected Results, then test case 1 is passed. Any deviation from the Expected Results is a failure for test case 1.

6.2 Test Case Number: 2

Requirements Tested: Micro controller, voltage regulator, and LED circuitry

Steps:

1- Connect JTAGICE3 debugger to ISP connection on blinking Frisbee PCB and PC USB connection.

2- Turn on power switch on PCB.

3- Start AVR Studio 6.0 on PC.

4- Select File, Open, Project/Solution, then select the test2 project location.

5- Once the test project is open, select Build and then Build Solution.

6- Select Device Programming.

7- Under Tool Select JTAGICE3, under Device select ATtiny461 and under Interface select ISP. Click the Apply button.

8- Click the Read button for Device Signature.

9- Click the Read button for Target Voltage.

10- Then select Memories, and click Program.

11- Close dialog box.

12- Select File, then Exit.

12.1 Disconnect Debugger from Frisbee

Input File Names: test2.c

Expected Results:

5- If build succeeded with zero failed or skipped then the program is properly compiled and ready to program the micro controller.

7- If the JTAGICE3 is recognized as an option not just Simulator, then debugger is properly connected to ISP connection on PCB and the ATtiny461 is properly powered up.

8- If a Device Signature is read (for example 0x1E9208) then the micro controller is properly powered up, and necessary connections for the micro controller are correctly made to include the ISP connections.

9- If the voltage reading is between 2.7 and 3.5, then the voltage regulator circuit and battery circuit is correct and batteries are at or near full charge.

10- If no errors messages occur, then micro controller is properly programmed with the test2.c program and one LED should be lit.

Actual Results: Passed

Output File Names: none

Pass / Fail Criteria: If the Actual Results exactly matches the Expected Results, then test case 2 is passed. Any deviation from the Expected Results is a failure for test case 2.

## 6.2 Test Case Number: 3

Requirements Tested: Counter and LED s

Steps:

1- Connect JTAGICE3 debugger to ISP connection on blinking Frisbee PCB and PC USB connection.

2- Turn on power switch on PCB.

3- Start AVR Studio 6.0 on PC.

4- Select File, Open, Project/Solution, then select the test2 project location.

5- Once the test3 project is open, select Build and then Build Solution.

6- Select Device Programming.

7- Under Tool Select JTAGICE3, under Device select ATtiny461 and under Interface select ISP. Click the Apply button.

8- Click the Read button for Device Signature.

9- Click the Read button for Target Voltage.

10- Then select Memories, and click Program.

11- Close dialog box.

12- Select File, then Exit.

Input File Names: test3.c

Expected Results:

5- If build succeeded with zero failed or skipped then the program is properly compiled and ready to program the micro controller.

7- If the JTAGICE3 is recognized as an option not just Simulator, then debugger is properly connected to ISP connection on PCB and the ATtiny461 is properly powered up.

8- If a Device Signature is read (for example 0x1E9208) then the micro controller is properly powered up, and necessary connections for the micro controller are correctly made to include the ISP connections.

9- If the voltage reading is between 2.7 and 3.5, then the voltage regulator circuit and battery circuit is correct and batteries are at or near full charge.

10- If no errors messages occur, then micro controller is properly programmed with the test2.c program. Program should step through one LED at a time changing the color from off to red, green, blue, then off again.

Actual Results: Passed

Output File Names: none

Pass / Fail Criteria: If the Actual Results exactly matches the Expected Results, then test case 3 is passed. Any deviation from the Expected Results is a failure for test case 3.

## 6.2.1 Test Case Number: 3A

Requirements Tested: Counter, LED s, Scheduler data structure

Steps:

1- Connect JTAGICE3 debugger to ISP connection on blinking Frisbee PCB and PC USB connection.

2- Turn on power switch on PCB.

3- Start AVR Studio 6.0 on PC.

4- Select File, Open, Project/Solution, then select the test2 project location.

5- Once the test3A project is open, select Build and then Build Solution.

6- Select Device Programming.

7- Under Tool Select JTAGICE3, under Device select ATtiny461 and under Interface select ISP. Click the Apply button.

8- Click the Read button for Device Signature.

9- Click the Read button for Target Voltage.

10- Then select Memories, and click Program.

11- Close dialog box.

12- Select File, then Exit.

Input File Names: test3A.c

Expected Results:

5- If build succeeded with zero failed or skipped then the program is properly compiled and ready to program the micro controller.

7- If the JTAGICE3 is recognized as an option not just Simulator, then debugger is properly connected to ISP connection on PCB and the ATtiny461 is properly powered up.

8- If a Device Signature is read (for example 0x1E9208) then the micro controller is properly powered up, and necessary connections for the micro controller are correctly made to include the ISP connections.

9- If the voltage reading is between 2.7 and 3.5, then the voltage regulator circuit and battery circuit is correct and batteries are at or near full charge.

10- If no errors messages occur, then micro controller is properly programmed with the test3A.c program. Program should light all LEDs different colors and shift LED colors roughly once a second.

Actual Results: Passed

Output File Names: none

Pass / Fail Criteria: If the Actual Results exactly matches the Expected Results, then test case 3A is passed. Any deviation from the Expected Results is a failure for test case 3A.

## 6.2.2 Test Case Number: 3B

Requirements Tested: Counter, LED s, Scheduler data structure

Steps:

1- Connect JTAGICE3 debugger to ISP connection on blinking Frisbee PCB and PC USB connection.

2- Turn on power switch on PCB.

3- Start AVR Studio 6.0 on PC.

4- Select File, Open, Project/Solution, then select the test3B project location.

5- Once the test2 project is open, select Build and then Build Solution.

6- Select Device Programming.

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

8- Click the Read button for Device Signature.

9- Click the Read button for Target Voltage.

10- Then select Memories, and click Program.

11- Close dialog box.

12- Select File, then Exit.

Input File Names: test3B.c

Expected Results:

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

10- If no errors messages occur, then micro controller is properly programmed with the test3B.c program. Program should light all LED s red, green, and blue.

Actual Results: Passed

Output File Names: none

Pass / Fail Criteria: If the Actual Results exactly matches the Expected Results, then test case 3B is passed. Any deviation from the Expected Results is a failure for test case 3B.

## 6.3 Test Case Number: 4

Requirements Tested: LED's react to gyro sensor

Steps:

1- After PCB has been potted and attached to LED s and Frisbee, run test case one and two again.

2- Connect JTAGICE3 debugger to ISP connection on blinking Frisbee PCB and PC USB connection.

3- Turn on power switch on PCB.

4- Start AVR Studio 6.0 on PC.

5- Select File, Open, Project/Solution, then select the test4 project location.

6- Once the test2 project is open, select Build and then Build Solution.

7- Select Device Programming.

8- Under Tool Select JTAGICE3, under Device select ATtiny461 and under Interface select ISP. Click the Apply button.

9- Click the Read button for Device Signature.

10- Click the Read button for Target Voltage.

11- Then select Memories, and click Program.

12- Close dialog box.

13- Select File, then Exit.

13.1 Disconnect Debugger from Frisbee

14- Spin flying disc on a lazy susan

15- Turn off power switch on Frisbee PCB.

Input File Names: test4.c

Expected Results:

1- Expected results should match Case 1 and Case 2

6- If build succeeded with zero failed or skipped then the program is properly compiled and ready to program the micro controller.

8- If the JTAGICE3 is recognized as an option not just Simulator, then debugger is properly connected to ISP connection on PCB and the ATtiny461 is properly powered up.

9- If a Device Signature is read (for example 0x1E9208) then the micro controller is properly powered up, and necessary connections for the micro controller are correctly made to include the ISP connections.

10- If the voltage reading is between 2.7 and 3.5, then the voltage regulator circuit and battery circuit is correct and batteries are at or near full charge.

11- If no errors messages occur, then micro controller is properly programmed with the test4.c program. All LEDs should be lit green at rest

14- When spun one way, LEDs sequentially light red based on speed. When spun the other way, LEDs sequentially light blue based on speed.

Actual Results: Passed

Output File Names: none

Pass / Fail Criteria: If the Actual Results exactly matches the Expected Results, then test case 4 is passed. Any deviation from the Expected Results is a failure for test case 4.

## 6.3 Test Case Number: 5

Requirements Tested: LED's react to gyro sensor

Steps:

1- After PCB has been potted and attached to LED s and Frisbee, run test case one and two again.

2- Connect JTAGICE3 debugger to ISP connection on blinking Frisbee PCB and PC USB connection.

3- Turn on power switch on PCB.

4- Start AVR Studio 6.0 on PC.

5- Select File, Open, Project/Solution, then select the frisbee_runtime project location.

6- Once the test2 project is open, select Build and then Build Solution.

7- Select Device Programming.

8- Under Tool Select JTAGICE3, under Device select ATtiny461 and under Interface select ISP. Click the Apply button.

9- Click the Read button for Device Signature.

10- Click the Read button for Target Voltage.

11- Then select Memories, and click Program.

12- Close dialog box.

13- Select File, then Exit.

13.1 Disconnect Debugger from Frisbee

14- Spin flying disc on a lazy susan

15- Turn off power switch on Frisbee PCB.

Input File Names: frisbee_runtime.c

Expected Results:

1- Expected results should match Case 1 and Case 2

6- If build succeeded with zero failed or skipped then the program is properly compiled and ready to program the micro controller.

8- If the JTAGICE3 is recognized as an option not just Simulator, then debugger is properly connected to ISP connection on PCB and the ATtiny461 is properly powered up.

9- If a Device Signature is read (for example 0x1E9208) then the micro controller is properly powered up, and necessary connections for the micro controller are correctly made to include the ISP connections.

10- If the voltage reading is between 2.7 and 3.5, then the voltage regulator circuit and battery circuit is correct and batteries are at or near full charge.

11- If no errors messages occur, then micro controller is properly programmed with the frisbee_runtime.c program. No LEDs should be lit at rest.

14- When spun one way, LEDs light based on 5 different preset patterns: All red, all green, all blue, and 2 modes that flash LEDs. A new pattern is displayed when the gyroscope transitions from below the threshold to above the threshold.

Actual Results: Passed

Output File Names: none

Pass / Fail Criteria: If the Actual Results exactly matches the Expected Results, then test case 5 is passed. Any deviation from the Expected Results is a failure for test case 5.

Rev. 12/7/2012 17 Test Plan.odt
