branstem/OperationAwesome/schematics/Unified_Circuit.brd

## EAGLE design schematics/Unified_Circuit.brd (2013-12-03)

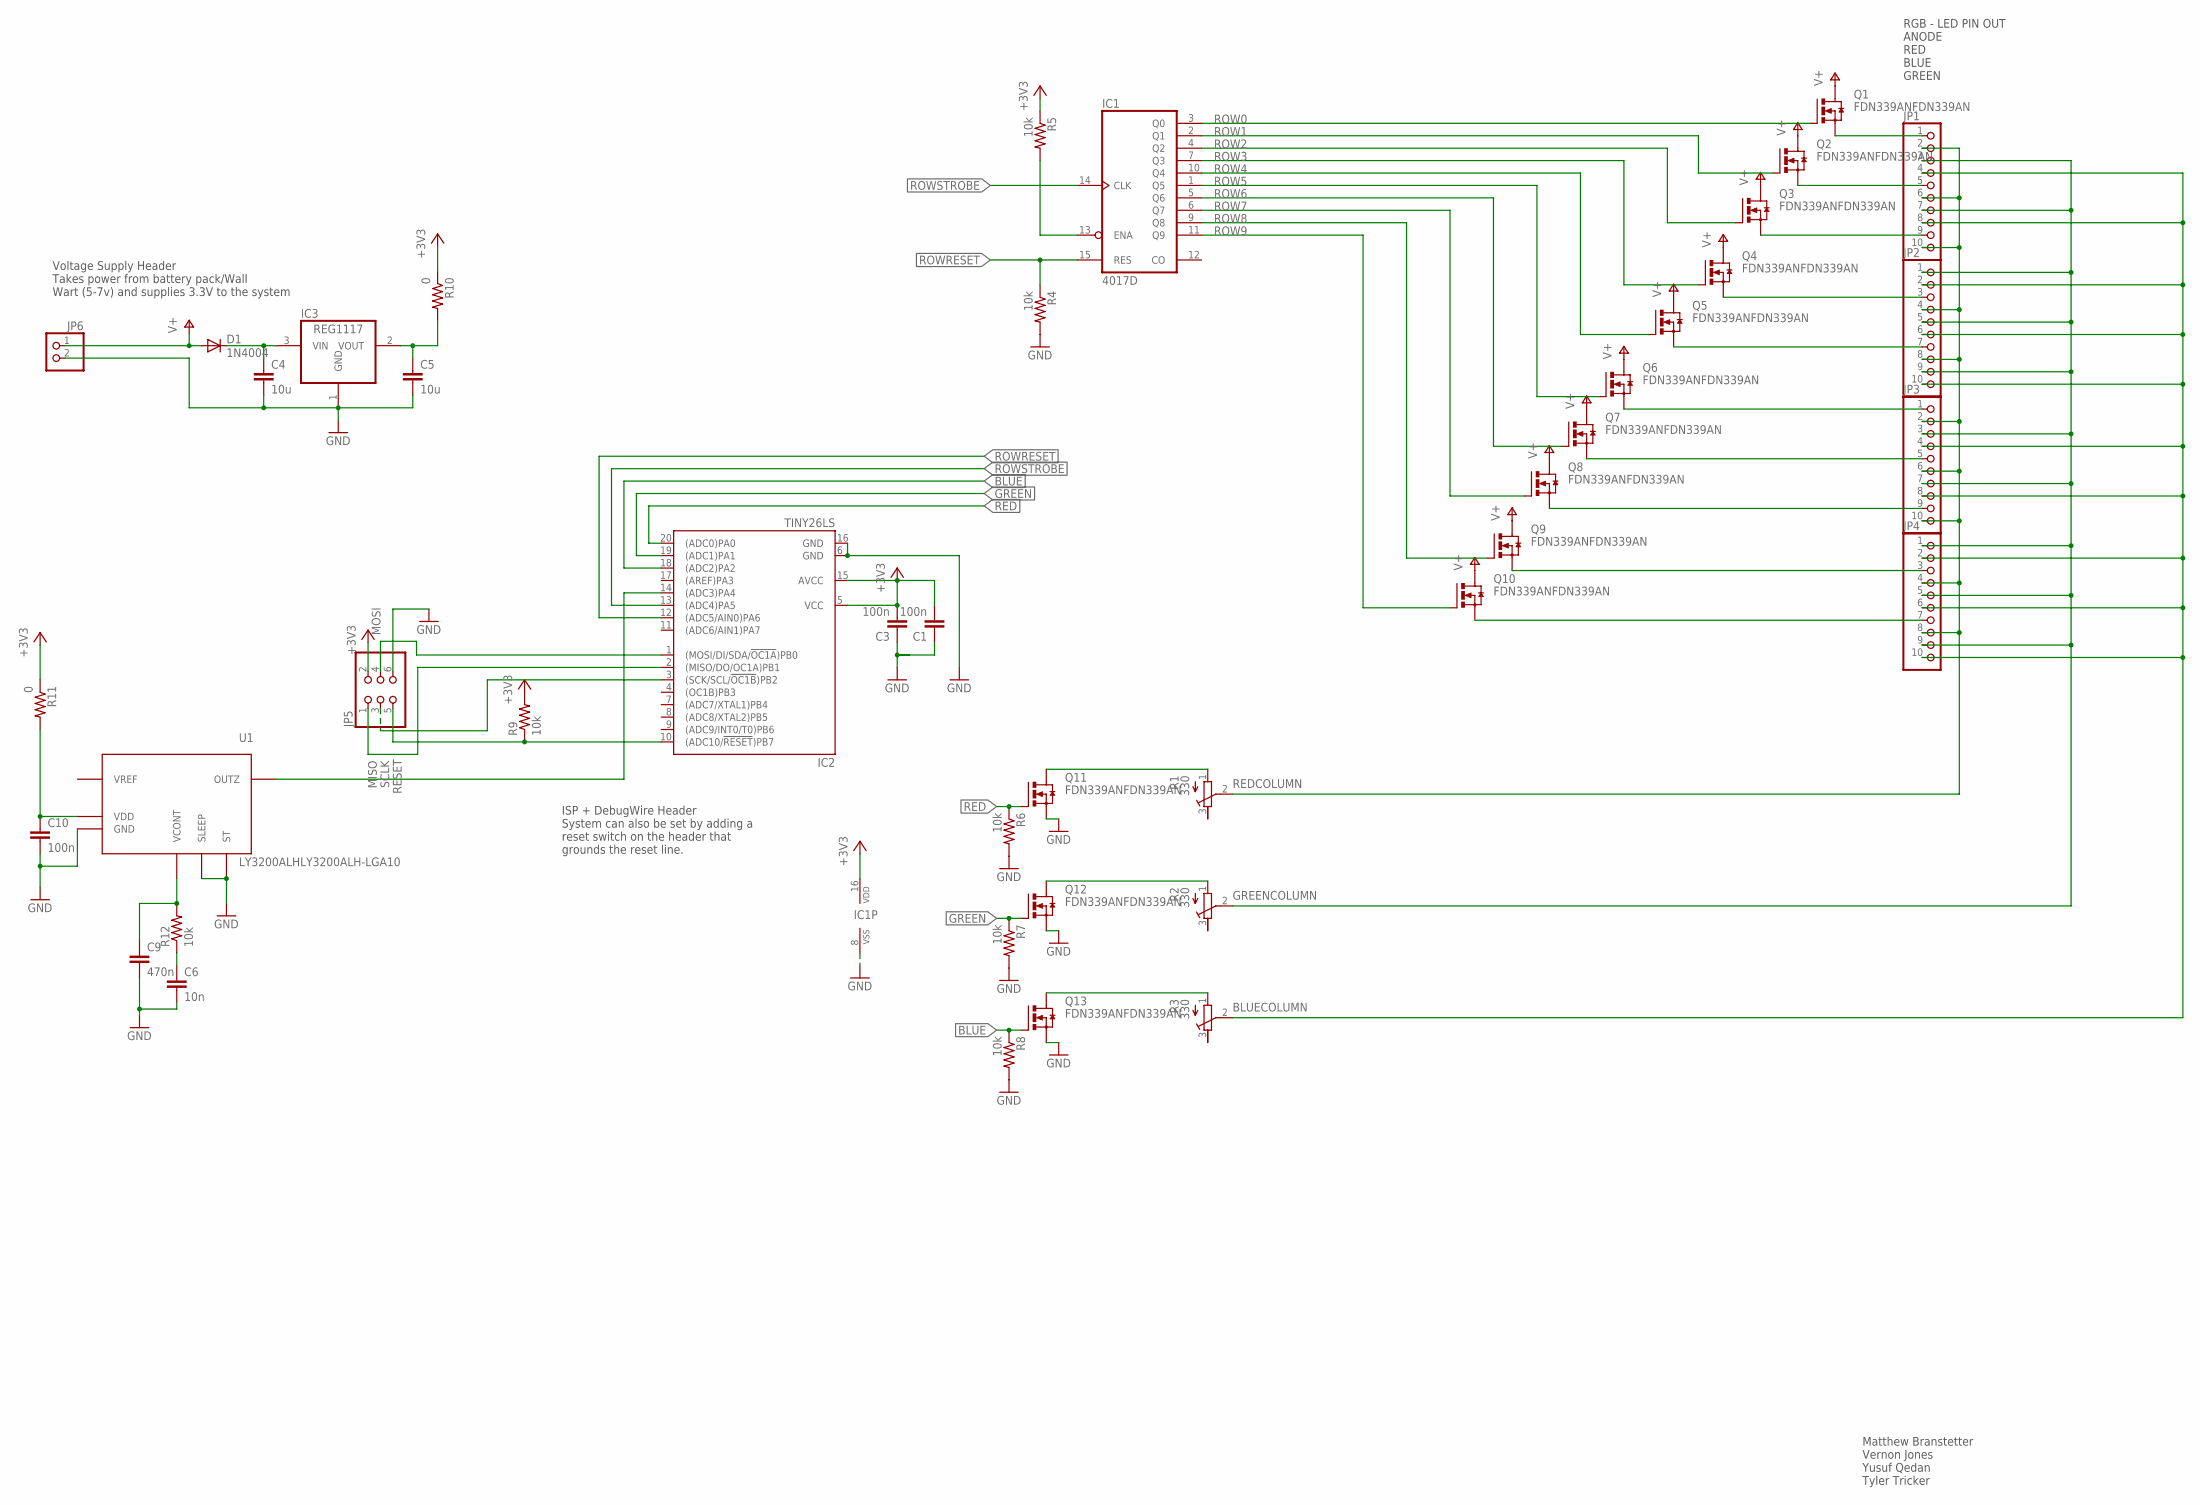
[picture p23: schematic Unified_Circuit.sch, LED Lighting Module - Multiplexed RGB Lighting system.]

Parts:
C1, C3, C10: 100n; C0805
C4, C5: 10u; C0805
C6: 10n; C0805
C9: 470n; C0805
D1: 1N4004; DO41-10
IC1: 4017D; SO16
IC2: TINY26LS; SO20L
IC3: REG1117; SOT223
JP1, JP2, JP3, JP4: PINHD-1X10/90; 1X10/90
JP5: PINHD-2X3; 2X03
JP6: PINHD-1X2; 1X02
Q1, Q2, Q3, Q4, Q5, Q6, Q7, Q8, Q9, Q10, Q11, Q12, Q13: FDN339ANFDN339AN; SSOT-3
R1, R2, R3: 330; RTRIM3224W
R4, R5, R6, R7, R8, R9, R12: 10k; R0805
R10, R11: 0; R0805
U1: LY3200ALHLY3200ALH-LGA10; LGA10

Connections:
+3V3: C1.2, C3.2, IC1.16 (VDD), IC2.5 (VCC), IC2.15 (AVCC), JP5.2, R5.1, R9.2, R10.1, R11.1
BLUE: IC2.18 ((ADC2)PA2), Q13.P$2 (G), R8.1
BLUECOLUMN: JP1.4, JP1.8, JP2.2, JP2.6, JP2.10, JP3.4, JP3.8, JP4.2, JP4.6, JP4.10, R3.2 (S)
GND: C1.1, C3.1, C4.2, C5.2, C6.2, C9.2, C10.2, IC1.8 (VSS), IC2.6 (GND), IC2.16 (GND), IC3.1 (GND), JP5.6, JP6.2, Q11.P$3 (S), Q12.P$3 (S), Q13.P$3 (S), R4.2, R6.2, R7.2, R8.2, U1.P$2 (ST), U1.P$4 (GND), U1.P$8 (SLEEP)
GREEN: IC2.19 ((ADC1)PA1), Q12.P$2 (G), R7.1
GREENCOLUMN: JP1.3, JP1.7, JP2.1, JP2.5, JP2.9, JP3.3, JP3.7, JP4.1, JP4.5, JP4.9, R2.2 (S)
MISO: IC2.2 ((MISO/DO/OC1A)PB1), JP5.1
MOSI: IC2.1 ((MOSI/DI/SDA/!OC1A!)PB0), JP5.4
unnamed: Q11.P$1 (D), R1.1 (A)
unnamed: Q12.P$1 (D), R2.1 (A)
unnamed: Q13.P$1 (D), R3.1 (A)
unnamed: C4.1, D1.C, IC3.3 (VIN)
unnamed: C5.1, IC3.2 (VOUT), R10.2
unnamed: IC2.14 ((ADC3)PA4), U1.P$6 (OUTZ)
unnamed: C6.1, R12.1
unnamed: JP2.3, Q4.P$3 (S)
unnamed: JP2.7, Q5.P$3 (S)
unnamed: JP1.1, Q1.P$3 (S)
unnamed: JP1.5, Q2.P$3 (S)
unnamed: JP1.9, Q3.P$3 (S)
unnamed: JP3.1, Q6.P$3 (S)
unnamed: JP3.5, Q7.P$3 (S)
unnamed: JP3.9, Q8.P$3 (S)
unnamed: JP4.3, Q9.P$3 (S)
unnamed: JP4.7, Q10.P$3 (S)
unnamed: C9.1, R12.2, U1.P$3 (VCONT)
unnamed: C10.1, R11.2, U1.P$1 (VDD), U1.P$9 (VDD)
PA1: IC1.13 (ENA), R5.2
RED: IC2.20 ((ADC0)PA0), Q11.P$2 (G), R6.1
REDCOLUMN: JP1.2, JP1.6, JP1.10, JP2.4, JP2.8, JP3.2, JP3.6, JP3.10, JP4.4, JP4.8, R1.2 (S)
RESET: IC2.10 ((ADC10/!RESET!)PB7), JP5.5, R9.1
ROW0: IC1.3 (Q0), Q1.P$2 (G)
ROW1: IC1.2 (Q1), Q2.P$2 (G)
ROW2: IC1.4 (Q2), Q3.P$2 (G)
ROW3: IC1.7 (Q3), Q4.P$2 (G)
ROW4: IC1.10 (Q4), Q5.P$2 (G)
ROW5: IC1.1 (Q5), Q6.P$2 (G)
ROW6: IC1.5 (Q6), Q7.P$2 (G)
ROW7: IC1.6 (Q7), Q8.P$2 (G)
ROW8: IC1.9 (Q8), Q9.P$2 (G)
ROW9: IC1.11 (Q9), Q10.P$2 (G)
ROWRESET: IC1.15 (RES), IC2.12 ((ADC5/AIN0)PA6), R4.1
ROWSTROBE: IC1.14 (CLK), IC2.13 ((ADC4)PA5)
SCLK: IC2.3 ((SCK/SCL/!OC1B!)PB2), JP5.3
V+: D1.A, JP6.1, Q1.P$1 (D), Q2.P$1 (D), Q3.P$1 (D), Q4.P$1 (D), Q5.P$1 (D), Q6.P$1 (D), Q7.P$1 (D), Q8.P$1 (D), Q9.P$1 (D), Q10.P$1 (D)

Notes on the sheet:
RGB - LED PIN OUT ANODE RED BLUE GREEN
ISP + DebugWire Header System can also be set by adding a reset switch on the header that grounds the reset line.
Voltage Supply Header Takes power from battery pack/Wall Wart (5-7v) and supplies 3.3V to the system
Matthew Branstetter Vernon Jones Yusuf Qedan Tyler Tricker

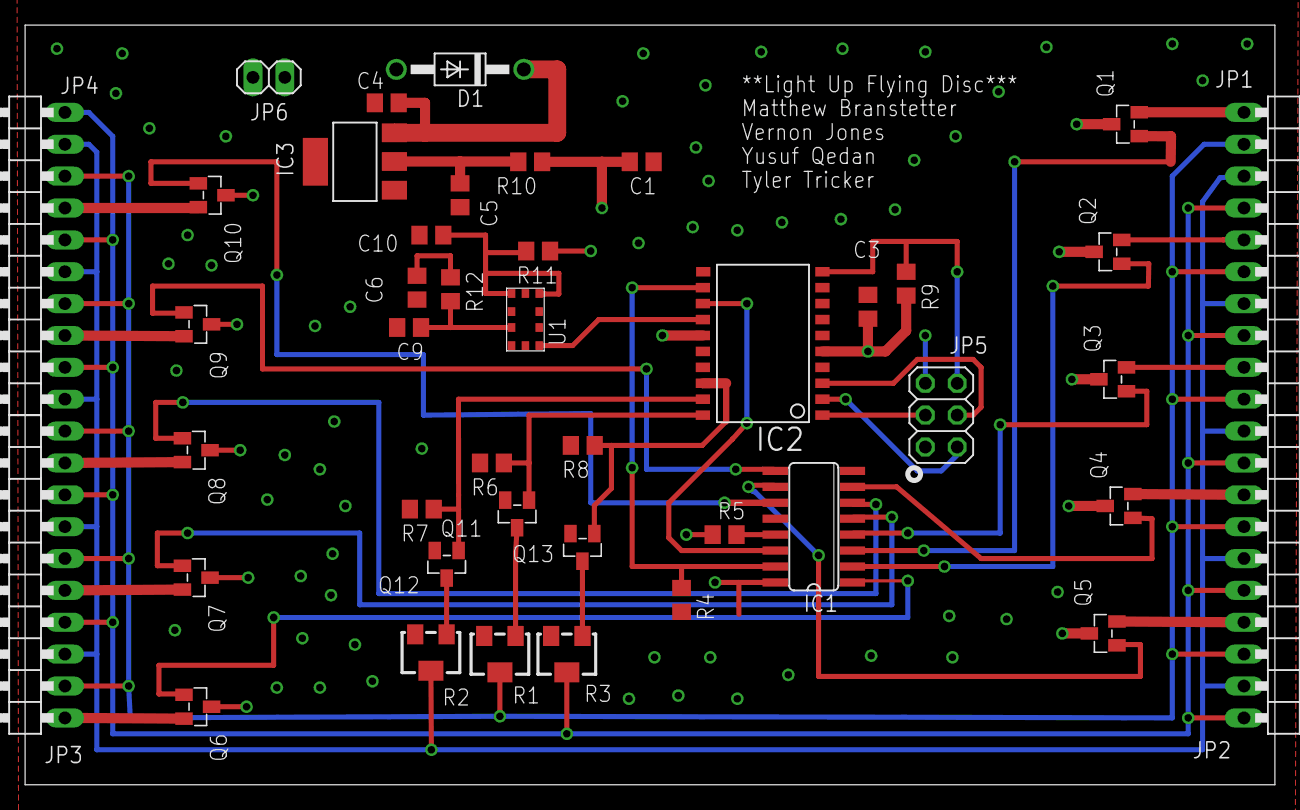
[picture p24: board Unified_Circuit.brd from above]

Board: 2 copper layers, 99.6 x 60.6 mm, 43 parts (0 on the bottom side), 45 nets.
